ezif/Formula-Student-Dashboard/README.md

# Formula Student Dashboard


Custom dashboard designed for a Formula Student vehicle, built around the Raspberry Pi Compute Module 4/5.

## Overview


Custom CM5 carrier PCB and a complete mechanical enclosure for the vehicle dashboard with an emphasis on weight, reliability, and cost.

### PCB


- Designed the custom Raspberry Pi CM5 carrier PCB from scratch in Altium Designer.
- Integrated USB, Ethernet, and HDMI connectivity.
- Designed power-down circuitry incorporating hold-up capacitors to provide stored energy during power loss.
- Implemented a hardware trigger interface to the microcontroller for power-down event handling.

## Features

- Custom CM5 carrier-board design
- USB, Ethernet, and HDMI interfaces
- Power-loss detection and controlled-shutdown support
- Capacitive energy storage for power-down handling
- Integrated electromechanical packaging

## Tools

- PCB design: Altium Designer
- Mechanical CAD: SolidWorks

## Status

- Deployed and active on Zips Racing ZR26 since May 2026
