ezif/Formula-Student-Dashboard/Gerbers/Revision AB/JLCPCB Dash REV AB BOM.xlsx

Line # | Name | Description | Designator | Quantity | Manufacturer 1 | Manufacturer Part Number 1 | LCSC Part Number | Supplier 1 | Supplier Part Number 1 | Supplier Unit Price 1 | Supplier Subtotal 1
 | 3034TR | Coin Cell Battery Holders COIN CELL RETAINER T APE/REEL 500PC | BT1 | 1 | Keystone | 3034TR | C5213768 | DigiKey | 36-3034CT-ND | 0.47 | 0.47
 | Capacitor 10nF 0603 5% | Capacitor, 0603, 5% | C18 | 1 | KEMET | C0603C103K4REC7867 | C57112
 | Capacitor 6.8pF 0603 5% | Capacitor, 0603, 5% | C28 | 1 | Murata | GCM1885C2A6R8BA16D | C162244 | DigiKey | 490-GCM1885C2A6R8BA16DCT-ND | 0.14 | 0.14
 | Capacitor 4.7nF 0603 10% | Capacitor, 0603, 5% | C29 | 1 | Murata | GCM188R72A472KA37D | C1621 | DigiKey | 490-4930-1-ND | 0.1 | 0.1
 | 293D107X9010D2TE3 | Solid Tantalum Chip Capacitor, 100 uF, +/- 10%, 10 V, -55 to 125 degC, 2917 (7343 Metric), RoHS, Tape and Reel | C38 | 1 | Vishay | 293D107X9010D2TE3 | 293D107X9010D2TE3 | Mouser | 74-293D107X9010D2TE3 | 0.66 | 0.66
 | B160B-13-F | Rectifier Diode, Schottky, 1 Phase, 1 Element, 1A, 60V V(RRM), Silicon | D6 | 1 | Diodes Inc. | B160B-13-F | C80301 | DigiKey | B160B-FDICT-ND | 0.32 | 0.32
 | VS-50WQ10FN-M3 | Rectifier Diode, Schottky, 1 Phase, 1 Element, 5.5A, 100V V(RRM), Silicon, TO-252AA | D7 | 1 | Vishay | VS-50WQ10FN-M3 | C5158795 | DigiKey | VS-50WQ10FN-M3-ND | 0.42 | 0.42
 | LTST-C190KFKT | LED Uni-Color Orange, 75 mW, 30 mA, -35 to 85 degC, 2-Pin SMD, RoHS, Tape and Reel | DS1 | 1 | Lite-On | LTST-C190KFKT | C157740 | DigiKey | 160-1434-1-ND | 0.11 | 0.11
 | LTST-C190GKT | LED Uni-Color Green, 100 mW, 30 mA, -55 to 85 degC, 2-Pin SMD, RoHS, Tape and Reel | DS2 | 1 | Lite-On | LTST-C190GKT | C125093 | DigiKey | 160-LTST-C190GKTDKR-ND | 0.14 | 0.14
 | 1747981-1 | HDMI Receptacle, Pitch 0.5 mm, 19 Position, Height 6.38 mm, RoHS, Tape and Reel | J1 | 1 | TE Connectivity | 1-1747981-1 | C428484 | Mouser | 571-1-1747981-1 | 5.73 | 5.73
 | NRS6028T4R7MMGKV | Inductor Power Shielded Wirewound 4.7uH 20% 100KHz Ferrite 3A 0.0403Ohm DCR 2424 Automotive T/R | L1 | 1 | TAIYO YUDEN | NRS6028T4R7MMGKV | DNP | Mouser | 963-NRS6028T4R7MMGKV | 0.29 | 0.29
 | 503148-2090 | Signal and Industrial Connectors; MOLEX; 503148-2090; Right Angle; JP; 2; Solder | P1 | 1 | Molex | 503148-2090 | DNP | DigiKey | WM9451CT-ND | 3.26 | 3.26
 | AP7343DQ-33W5-7 | Fixed Positive LDO Regulator | PS1 | 1 | Diodes Inc. | AP7343DQ-33W5-7 | C5183854 | DigiKey | AP7343DQ-33W5-7DICT-ND | 0.2 | 0.2
 | CRM2512-FX-1R00ELF | CRCW FIXED RESISTOR 2512 (6432Metric) Chip Resistor ±1% ±100ppm/C 1.1kOhm 1W | R7 | 1 | Bourns | CRM2512-FX-1R00ELF | C11254 | Mouser | 652-CRM2512FX1R00ELF | 0.7 | 0.7
 | Resistor 60k4 0603 1% | Resistor, 0603, 1%, 1/10W | R8 | 1 | Stackpole Electronics | RMCF0603FT60K4 | C23089 | DigiKey | RMCF0603FT60K4CT-ND | 0.1 | 0.1
 | Resistor 23k7 0603 1% | Resistor, 0603, 1%, 1/10W | R11 | 1 | Stackpole Electronics | RMCF0603FT23K7 | C22912 | DigiKey | RMCF0603FT23K7CT-ND | 0.1 | 0.1
 | Resistor 1k21 0603 1% | Resistor, 0603, 1%, 1/10W | R17 | 1 | Stackpole Electronics | RMCF0603FT1K21 | C137779 | DigiKey | RMCF0603FT1K21CT-ND | 0.1 | 0.1
 | Resistor 15k 0603 1% | Resistor, 0603, 1%, 1/10W | R31 | 1 | Stackpole Electronics | RMCF0603FT15K0 | C177330 | DigiKey | RMCF0603FT15K0CT-ND | 0.1 | 0.1
 | PT61020EL | Telecom Transformer 1CT: 1 0.9Ohm Prim. DCR 0.9Ohm Sec. DCR 24 Terminal Gull Wing SMD | T1 | 1 | Bourns | PT61020EL | C840585 | Mouser | 652-PT61020EL | 2.54 | 2.54
 | RT9742SNGV | USWI00154 / RT9742SNGV; Available until stocks are exhausted | U3 | 1 | Richtek | RT9742SNGV | C3235509 | DigiKey | 1028-RT9742SNGVCT-ND | 0.41 | 0.41
 | TPS54560BQDDARQ1 | Switching Regulator, Current-mode, 5A, 2500kHz Switching Freq-Max, PDSO8 | U4 | 1 | Texas Instruments | TPS54560BQDDARQ1 | DNP | DigiKey | 296-45534-1-ND | 6.54 | 6.54
 | AP22653FDZ-7 | USB Power High Side Switch Single 3V to 5.5V 2.1A 6-Pin WDFN-2020 T/R | U8 | 1 | Diodes Inc. | AP22653FDZ-7 | AP22653FDZ-7 | DigiKey | 31-AP22653FDZ-7CT-ND | 0.36 | 0.36
 | CM5108032 | Raspberry Pi Compute Module CM5 | U9 | 1 |  |  | DNP
 | Capacitor 4.7uF 1210 50V | Capacitor 1210 | C20, C21 | 2 | Samsung Electro-Mechanics | CL32B475KBUYNNE | C47783 | DigiKey | 1276-1292-1-ND | 0.36 | 0.72
 | 47uF 1210 16V | Capacitor 1210 | C22, C23 | 2 | Samsung | CL32A476KOJNNNE | C90142
 | Capacitor 1uF 0805 25V | Capacitor, 0805 | C33, C34 | 2 | Samsung Electro-Mechanics | CL21B105KAFNNNE | C28323 | Mouser | 187-CL21B105KAFNNNE | 0.009 | 0.09
 | PESD1CAN-UX | Trans Voltage Suppressor Diode, 150W, 24V V(RWM), Bidirectional, 2 Element, Silicon | D1, D2 | 2 | Nexperia | PESD1CAN-UX | C152727 | DigiKey | 1727-1306-1-ND | 0.5 | 1
 | 502494-0470 | 2.00mm Pitch CLIK-Mate Wire-to-Board PCB Receptacle, Single Row, Right-Angle, 4 Circuits | J2, J3 | 2 | Molex | 502494-0470 | C587929 | Mouser | 538-502494-0470 | 0.62 | 1.24
 | R-78E12-0.5 | Linear Regulator Replacement DC DC Converter 1 Output 5V - - 1A 8V - 28V Input | PS?_CAN Interface1, PS?_CAN Interface2 | 2 |  |  | DNP
 | DMP2045U-7 | DMP2045U Series 20 V 4.3 A P-Channel Enhancement Mode Mosfet - SOT-23-3 | Q1, Q2 | 2 | Diodes Inc. | DMP2045U-7 | C459541 | Mouser | 621-DMP2045U-7 | 0.17 | 0.34
 | Resistor 4k7 0603 1% | Resistor, 0603, 1%, 1/10W | R1, R2 | 2 | Stackpole Electronics | RMCF0603FT4K70 | C23162 | Mouser | 708-RMCF0603FT4K70 | 0.006 | 0.06
 | Resistor 150k 0603 1% | Resistor, 0603, 1%, 1/10W | R13, R16 | 2 | Stackpole Electronics | RMCF0603FT150K | C22807 | DigiKey | RMCF0603FT150KCT-ND | 0.006 | 0.06
 | MCP25625-E/SS | Interface Circuit, PDSO28 | U1, U2 | 2 | Microchip | MCP25625-E/SS | C184944 | Mouser | 579-MCP25625-E/SS | 3.38 | 6.76
 | ECS-160-20-3X-TR | Crystal 16MHz ±30ppm (Tol) ±50ppm (Stability) 20pF FUND 50Ohm 2-Pin HC-49/USX SMD T/R | Y1, Y2 | 2 | ECS International | ECS-160-20-3X-TR | C387623 | DigiKey | XC1776CT-ND | 0.3 | 0.6
 | Capacitor 10F 0805 5% | Capacitor, 0805, 5% | C35, C36, C37 | 3 | Murata | GRM21BC8YA106ME11L | C15850 | DigiKey | 490-10505-1-ND | 0.28 | 0.84
 | TPD4EUSB30DQAR | Quad 0.8-pF, 5.5-V, ±8-kV ESD protection diode with 5-A 8/20-uS surge rating for USB 3.0 10-USON -40 to 85 | D3, D4, D7 | 3 | Texas Instruments | TPD4EUSB30DQAR | C90627 | DigiKey | 296-28063-6-ND | 1.41 | 4.23
 | TS391IYLT | Low power, single voltage comparator, 200µA, 34V, -37, -40 to 125°C, SOT23-5L, Tape and Reel | U5, U6, U7 | 3 | STMicroelectronics | TS391IYLT | C283306 | Mouser | 511-TS391IYLT | 1.3 | 3.9
 | FC0H224ZFTBR24 | Cap Supercap 0.22F 5.5V -20% to 80% (10.5 X 8.5mm) SMD Cylindrical 25 Ohm 70C T/R | C24, C25, C26, C27 | 4 | KEMET | FC0H224ZFTBR24 | DNP | DigiKey | 399-10941-1-ND | 3.29 | 13.16
 | Resistor 75R 0603 1% | Resistor, 0603, | R3, R4, R5, R6, R10, R15 | 6 | Stackpole Electronics | RMCF0603FT75R0 | C4275 | DigiKey | RMCF0603FT75R0CT-ND | 0.007 | 0.07
 | Resistor 787R 0603 1% | Resistor, 0603, 787R | R18, R21, R22, R23, R24, R25, R26 | 7 | Stackpole Electronics | RMCF0603FT787R | C22369675 | DigiKey | RMCF0603FT787RCT-ND | 0.02 | 0.2
 | Capacitor 22nF 0603 5% | Capacitor, 0603, 5% | C4, C5, C9, C10, C13, C14, C15, C16 | 8 | Murata | GCM188R72A223KA37J | C21122 | Mouser | 81-GCM188R72A223KA7J | 0.035 | 0.35
 | Resistor 11k5 0603 1% | Resistor, 0603, 1%, 1/10W | R9, R12, R14, R19, R20, R27, R28, R29, R30 | 9 | Stackpole Electronics | RMCF0603FT11K5 | C177454 | DigiKey | RMCF0603FT11K5CT-ND | 0.006 | 0.06
 | Capacitor 100nF 0603 5% | Capacitor, 0603, 5% | C1, C2, C3, C6, C7, C8, C11, C12, C17, C19, C30, C31, C32 | 13 | KYOCERA AVX | KGM15BR71H104JT | C1591 | Mouser | 581-KGM15BR71H104JT | 0.051 | 0.663
 | 5019 | Interconnection Device | 1, CAP1, CS1, CS2, GD1, GND1, IN+1, INT1, INT2, MISO1, MISO2, MOSI1, MOSI2, PDWN1, PRE1, SCK1, SCK2, SRC1, STBY1, STBY2, VIN1 | 21 | Keystone | 5019 | C238131 | DigiKey | 36-5019CT-ND | 0.186 | 3.91
