ezif/Formula-Student-Dashboard/Gerbers/Revision AA/Working Board Dashboard REVAA.xlsx

Line # | Name | Description | Designator | Quantity | Manufacturer 1 | Manufacturer Part Number 1 | Manufacturer Lifecycle 1 | Supplier 1 | Supplier Part Number 1 | Supplier Unit Price 1 | Supplier Subtotal 1
 | 3034TR | Coin Cell Battery Holders COIN CELL RETAINER T APE/REEL 500PC | BT1 | 1 | Keystone | 3034TR | Volume Production | DigiKey | 36-3034CT-ND | 0.47 | 0.47
 | Capacitor 10nF 0603 5% | Capacitor, 0603, 5% | C18 | 1 | KEMET | C0603C103K4REC7867 | Unknown | Arrow Electronics | C0603C103K4REC7867 | 0.0143 | 57.2
 | Capacitor 10uF 1210 50V | Capacitor 1210 | C28 | 1 | Samsung Electro-Mechanics | CL32A106KBJNNNE | Volume Production | DigiKey | 1276-3363-6-ND | 0.52 | 0.52
 | Capacitor 47uF 1206 20% | 1206 47 uF 6.3 V ±20% Tolerance X7U Multilayer Ceramic Chip Capacitor | C29 | 1 | Murata | GRM31CE70J476ME15L | Volume Production | Future Electronics | 1104123 | 0.355 | 0.355
 | 293D107X9010D2TE3 | Solid Tantalum Chip Capacitor, 100 uF, +/- 10%, 10 V, -55 to 125 degC, 2917 (7343 Metric), RoHS, Tape and Reel | C38 | 1 | Vishay | 293D107X9010D2TE3 | Volume Production | Conrad | 3027093 | 0.62924 | 0.62924
 | B160B-13-F | Rectifier Diode, Schottky, 1 Phase, 1 Element, 1A, 60V V(RRM), Silicon | D5 | 1 | Diodes Inc. | B160B-13-F | Volume Production | Mouser | 621-B160B-F | 0.32 | 0.32
 | LTST-C190KFKT | LED Uni-Color Orange, 75 mW, 30 mA, -35 to 85 degC, 2-Pin SMD, RoHS, Tape and Reel | DS1 | 1 | Lite-On | LTST-C190KFKT | Volume Production | Arrow Electronics | LTST-C190KFKT | 0.009 | 0.009
 | LTST-C190GKT | LED Uni-Color Green, 100 mW, 30 mA, -55 to 85 degC, 2-Pin SMD, RoHS, Tape and Reel | DS2 | 1 | Lite-On | LTST-C190GKT | Not Recommended for New Design | DigiKey | 160-LTST-C190GKTDKR-ND | 0.12 | 0.12
 | 1747981-1 | HDMI Receptacle, Pitch 0.5 mm, 19 Position, Height 6.38 mm, RoHS, Tape and Reel | J1 | 1 | TE Connectivity | 1-1747981-1 | Volume Production | Mouser | 571-1-1747981-1 | 5.23 | 5.23
 | USB-A1HSW6 |  | J2 | 1
 | 9-1462038-9 | Rf Relay, Dpdt, Momentary, 0.028A (Coil), 5Vdc (Coil), 140Mw (Coil), 5A (Contact), 220Vdc | K1 | 1
 | VLS6045EX-6R8M | Inductor Power Shielded Wirewound 6.8uH 20% 100KHz Ferrite 3.6A 0.0468Ohm DCR 2424 T/R | L1 | 1 | TDK | VLS6045EX-6R8M | Volume Production | Mouser | 810-VLS6045EX-6R8M | 0.3 | 0.3
 | 503148-2090 | Signal and Industrial Connectors; MOLEX; 503148-2090; Right Angle; JP; 2; Solder | P1 | 1 | Molex | 503148-2090 | Volume Production | DigiKey | WM9451CT-ND | 3.26 | 3.26
 | AP7343DQ-33W5-7 | Fixed Positive LDO Regulator | PS1 | 1 | Diodes Inc. | AP7343DQ-33W5-7 | Volume Production | DigiKey | AP7343DQ-33W5-7DICT-ND | 0.2 | 0.2
 | RES_2512_33 | RES SMD 33 OHM 1% 2512 | R14 | 1
 | 5033981892 | Micro SD Card Connector, Pitch 1.1 mm, 8 Position, Height 1.4 mm, -25 to 85 degC, RoHS, Tape and Reel | SKT1 | 1 | Molex | 503398-1892 | Volume Production | Conrad | 2449113 | 1.57 | 1.57
 | PT61020EL | Telecom Transformer 1CT: 1 0.9Ohm Prim. DCR 0.9Ohm Sec. DCR 24 Terminal Gull Wing SMD | T1 | 1 | Bourns | PT61020EL | Volume Production | DigiKey | PT61020ELCT-ND | 2.54 | 2.54
 | RT9742SNGV | USWI00154 / RT9742SNGV; Available until stocks are exhausted | U3 | 1 | Richtek | RT9742SNGV | Volume Production | DigiKey | 1028-RT9742SNGVCT-ND | 0.41 | 0.41
 | LMR51430XDDCR | SIMPLE SWITCHER® 4.5-V to 36-V, 3-A synchronous buck converter with 40-µA IQ 6-SOT-23-THIN -40 to 150 | U4 | 1 | Texas Instruments | LMR51430XDDCR | Volume Production | DigiKey | 296-LMR51430XDDCRDKR-ND | 1.58 | 1.58
 | LM393DR2G | LM Series 36 V 250 nA Surface Mount Low Offset Voltage Dual Comparator - SOIC-8 | U5 | 1 | onsemi | LM393DR2G | Volume Production | Conrad | 3028167 | 0.15148 | 0.15148
 | RT9742GGJ5 | 2.7V~6V 70mΩ 1A TSOT-23-5 Power Distribution Switches ROHS | U6 | 1 | Richtek | RT9742GGJ5 | Volume Production | DigiKey | 1028-1436-1-ND | 0.58 | 0.58
 | AP22653W6-7 | USB Power High Side Switch Single 3V to 5.5V 2.1A 6-Pin SOT-26 T/R | U7 | 1 | Diodes Inc. | AP22653W6-7 | Volume Production | Newark | AP22653W6-7 | 0.36 | 1.8
 | CM5108032 | Raspberry Pi Compute Module CM5 | U8 | 1
 | Capacitor 1uF 0805 25V | Capacitor, 0805 | C31, C32 | 2 | Samsung Electro-Mechanics | CL21B105KAFNNNE | Volume Production | DigiKey | 1276-1066-1-ND | 0.009 | 0.09
 | PESD1CAN-UX | Trans Voltage Suppressor Diode, 150W, 24V V(RWM), Bidirectional, 2 Element, Silicon | D1, D2 | 2 | Nexperia | PESD1CAN-UX | Volume Production
 | TPD4EUSB30DQAR | Quad 0.8-pF, 5.5-V, ±8-kV ESD protection diode with 5-A 8/20-uS surge rating for USB 3.0 10-USON -40 to 85 | D3, D4 | 2 | Texas Instruments | TPD4EUSB30DQAR | Volume Production | DigiKey | 296-28063-1-ND | 1.25 | 2.5
 | 502494-0470 | 2.00mm Pitch CLIK-Mate Wire-to-Board PCB Receptacle, Single Row, Right-Angle, 4 Circuits | J3, J4 | 2 | Molex | 502494-0470 | Volume Production | Arrow Electronics | 5024940470 | 0.194 | 0.388
 | DMP2045U-7 | DMP2045U Series 20 V 4.3 A P-Channel Enhancement Mode Mosfet - SOT-23-3 | Q1, Q2 | 2 | Diodes Inc. | DMP2045U-7 | Volume Production | RS (Formerly Allied Electronics) | 73928969 | 0.054 | 0.108
 | Resistor 4k7 0603 1% | Resistor, 0603, 1%, 1/10W | R1, R2 | 2 | Stackpole Electronics | RMCF0603FT4K70 | Volume Production | Mouser | 708-RMCF0603FT4K70 | 0.01 | 0.1
 | Resistor 604k 0603 1% | Resistor, 1%, 0603 | R12, R20 | 2 | Stackpole Electronics | RMCF0603FT604K | Volume Production | Mouser | 708-RMCF0603FT604K | 0.007 | 0.07
 | MCP25625-E/SS | Interface Circuit, PDSO28 | U1, U2 | 2 | Microchip | MCP25625-E/SS | Volume Production | Arrow Electronics | MCP25625-E/SS | 1.21 | 2.41
 | ECS-160-20-3X-TR | Crystal 16MHz ±30ppm (Tol) ±50ppm (Stability) 20pF FUND 50Ohm 2-Pin HC-49/USX SMD T/R | Y1, Y2 | 2 | ECS International | ECS-160-20-3X-TR | Volume Production | DigiKey | XC1776CT-ND | 0.3 | 0.6
 | Resistor 15k 0603 1% | Resistor, 0603, 1%, 1/10W | R8, R18, R22 | 3 | Stackpole Electronics | RMCF0603FT15K0 | Volume Production | Mouser | 708-RMCF0603FT15K0 | 0.007 | 0.07
 | Capacitor 47pF +/- 5% 0603 C0G | Capacitor, 0603, 5% | C4, C5, C9, C10 | 4 | TDK | C1608C0G1H470J080AA | Volume Production | Newark | C1608C0G1H470J080AA | 0.007 | 0.028
 | Capacitor 22nF 0603 5% | Capacitor, 0603, 5% | C13, C14, C15, C16 | 4 | Murata | GCM188R72A223KA37J | Volume Production | Mouser | 81-GCM188R72A223KA7J | 0.032 | 0.32
 | Capacitor 10F 0805 5% | Capacitor, 0805, 5% | C34, C35, C36, C37 | 4 | Murata | GRM21BC8YA106ME11L | Volume Production | DigiKey | 490-10505-1-ND | 0.28 | 1.12
 | Resistor 75R 0603 1% | Resistor, 0603, | R3, R4, R5, R6, R9, R15 | 6 | Stackpole Electronics | RMCF0603FT75R0 | Volume Production | Mouser | 708-RMCF0603FT75R0 | 0.01 | 0.1
 | FC0H224ZFTBR24 | Cap Supercap 0.22F 5.5V -20% to 80% (10.5 X 8.5mm) SMD Cylindrical 25 Ohm 70C T/R | C20, C21, C22, C23, C24, C25, C26, C27 | 8 | KEMET | FC0H224ZFTBR24 | Volume Production | Mouser | 80-FC0H224ZFTBR24 | 2.13 | 21.3
 | Resistor 100k 0603 1% | Resistor, 0603, 1%, 1/10W | R7, R10, R11, R13, R17, R19, R21 | 8 | Stackpole Electronics | RMCF0603FT100K | Volume Production | Mouser | 708-RMCF0603FT100K | 0.007 | 0.07
 | Capacitor 100nF 0603 5% | Capacitor, 0603, 5% | C1, C2, C3, C6, C7, C8, C11, C12, C17, C19, C23 | 11 | KYOCERA AVX | KGM15BR71H104JT | Volume Production | Mouser | 581-KGM15BR71H104JT | 0.051 | 0.561
