ezif/Formula-Student-Dashboard/Gerbers/Revision AC/Zips Racing Dashboard Revision AC JLC.xlsx

LCSC Part Number | Name | Description | Designator | Quantity | Manufacturer 1 | Manufacturer Part Number 1 | Manufacturer Lifecycle 1 | Supplier 1 | Supplier Part Number 1 | Supplier Unit Price 1 | Supplier Subtotal 1
C428484 | 1747981-1 | HDMI Receptacle, Pitch 0.5 mm, 19 Position, Height 6.38 mm, RoHS, Tape and Reel | J1 | 1 | TE Connectivity | 1-1747981-1 | Volume Production | Mouser | 571-1-1747981-1 | 6.01 | 6.01
C840585 | PT61020EL | Telecom Transformer 1CT: 1 0.9Ohm Prim. DCR 0.9Ohm Sec. DCR 24 Terminal Gull Wing SMD | T1 | 1 | Bourns | PT61020EL | Volume Production | Mouser | 652-PT61020EL | 2.54 | 2.54
TPS54560BQDDARQ1 | TPS54560BQDDARQ1 | Switching Regulator, Current-mode, 5A, 2500kHz Switching Freq-Max, PDSO8 | U4 | 1 | Texas Instruments | TPS54560BQDDARQ1 | Volume Production | DigiKey | 296-45534-1-ND | 6.54 | 6.54
TS391IYLT | TS391IYLT | Low power, single voltage comparator, 200µA, 34V, -37, -40 to 125°C, SOT23-5L, Tape and Reel | U5 | 1 | STMicroelectronics | TS391IYLT | Volume Production | Mouser | 511-TS391IYLT | 1.18 | 1.18
C3001604 | AP22653FDZ-7 | USB Power High Side Switch Single 3V to 5.5V 2.1A 6-Pin WDFN-2020 T/R | U9 | 1 | Diodes Inc. | AP22653FDZ-7 | Volume Production | DigiKey | 31-AP22653FDZ-7CT-ND | 0.36 | 0.36
C597931 | DF40C-100DS-0.4V(51) | Conn Stacking Receptacle 100 POS 1.5mm Stack Height 0.4mm Solder ST SMD Emboss T/R | J3, J4 | 2 | HIROSE ELECTRIC | DF40C-100DS-0.4V(51) | Volume Production | Mouser | 798-DF40C100DS0.4V51 | 1.76 | 3.52
C90627 | TPD4EUSB30DQAR | Quad 0.8-pF, 5.5-V, ±8-kV ESD protection diode with 5-A 8/20-uS surge rating for USB 3.0 10-USON -40 to 85 | D3, D4, D5 | 3 | Texas Instruments | TPD4EUSB30DQAR | Volume Production | Bison Technologies | TPD4EUSB30DQAR-62989 | 0.23 | 23
C90142 | 47uF 1210 16V | Capacitor 1210 | C26, C27, C35, C36 | 4 | Samsung | CL32A476KOJNNNE | Unknown
C283306 | Resistor 75R 0603 1% | Resistor, 0603, | R3, R4, R5, R6 | 4 | Stackpole Electronics | RMCF0603FT75R0 | Volume Production | DigiKey | RMCF0603FT75R0CT-ND | 0.007 | 0.07
C177644 | Resistor 10k 0603 1% | Resistor, 0603, 10k | R8, R9, R10, R11 | 4 | Stackpole Electronics | RMCF0603FT10K0 | Volume Production | DigiKey | RMCF0603FT10K0CT-ND | 0.006 | 0.06
C283306 | EEE-FK1V751SQ | Panasonic EEEFK1V751SQ - Aluminum Electrolytic Capacitors (Surface Mount Type) | C28, C29, C30, C31, C39 | 5 | Panasonic | EEE-FK1V751SQ | Volume Production | Mouser | 667-EEE-FK1V751SQ | 1.8 | 9
C177454 | Resistor 11k5 0603 1% | Resistor, 0603, 1%, 1/10W | R17, R24, R25, R32, R33 | 5 | Stackpole Electronics | RMCF0603FT11K5 | Volume Production | DigiKey | RMCF0603FT11K5CT-ND | 0.006 | 0.06
C24452 | Capacitor 100nF 0603 5% | Capacitor, 0603, 5% | C1, C2, C3, C6, C7, C8, C11, C12, C17, C19, C34 | 11 | KYOCERA AVX | KGM15BR71H104JT | Volume Production | Mouser | 581-KGM15BR71H104JT | 0.051 | 0.561
