ezif/Formula-Student-Dashboard/Gerbers/Revision AC/Zips Racing Dashboard Revision AC.xlsx

Line # | Name | Description | Designator | Quantity | Manufacturer 1 | Manufacturer Part Number 1 | Manufacturer Lifecycle 1 | Supplier 1 | Supplier Part Number 1 | Supplier Unit Price 1 | Supplier Subtotal 1
 | Capacitor 10nF 0603 5% | Capacitor, 0603, 5% | C18 | 1 | KEMET | C0603C103K4REC7867 | Unknown
 | 293D107X9010D2TE3 | Solid Tantalum Chip Capacitor, 100 uF, +/- 10%, 10 V, -55 to 125 degC, 2917 (7343 Metric), RoHS, Tape and Reel | C23 | 1 | Vishay | 293D107X9010D2TE3 | Volume Production | Mouser | 74-293D107X9010D2TE3 | 0.6 | 0.6
 | Capacitor 6.8pF 0603 5% | Capacitor, 0603, 5% | C32 | 1 | Murata | GCM1885C2A6R8BA16D | Volume Production | Mouser | 81-GCM1885C2A6R8BA6D | 0.14 | 0.14
 | Capacitor 4.7nF 0603 10% | Capacitor, 0603, 5% | C33 | 1 | Murata | GCM188R72A472KA37D | Not Recommended for New Design | DigiKey | 490-4930-1-ND | 0.1 | 0.1
 | VS-50WQ10FN-M3 | Rectifier Diode, Schottky, 1 Phase, 1 Element, 5.5A, 100V V(RRM), Silicon, TO-252AA | D7 | 1 | Vishay | VS-50WQ10FN-M3 | Volume Production | Mouser | 78-VS-50WQ10FN-M3 | 0.31 | 0.31
 | LTST-C190KFKT | LED Uni-Color Orange, 75 mW, 30 mA, -35 to 85 degC, 2-Pin SMD, RoHS, Tape and Reel | DS1 | 1 | Lite-On | LTST-C190KFKT | Volume Production | DigiKey | 160-1434-1-ND | 0.11 | 0.11
 | CM5-ICON | Raspberry Pi Compute Module CM5 | ICON1 | 1
 | 1747981-1 | HDMI Receptacle, Pitch 0.5 mm, 19 Position, Height 6.38 mm, RoHS, Tape and Reel | J1 | 1 | TE Connectivity | 1-1747981-1 | Volume Production | Mouser | 571-1-1747981-1 | 6.01 | 6.01
 | NRS6028T4R7MMGKV | Inductor Power Shielded Wirewound 4.7uH 20% 100KHz Ferrite 3A 0.0403Ohm DCR 2424 Automotive T/R | L1 | 1 | TAIYO YUDEN | NRS6028T4R7MMGKV | Volume Production | DigiKey | 587-3639-1-ND | 0.29 | 0.29
 | 503148-2090 | Signal and Industrial Connectors; MOLEX; 503148-2090; Right Angle; JP; 2; Solder | P1 | 1 | Molex | 503148-2090 | Volume Production | DigiKey | WM9451CT-ND | 3.26 | 3.26
 | AP7343DQ-33W5-7 | Fixed Positive LDO Regulator | PS1 | 1 | Diodes Inc. | AP7343DQ-33W5-7 | Volume Production | DigiKey | AP7343DQ-33W5-7DICT-ND | 0.2 | 0.2
 | R-78E5.0-1.0 | Linear Regulator Replacement DC DC Converter 1 Output 5V - - 1A 8V - 28V Input | PS2 | 1 | Recom Power | R-78E5.0-1.0 | Volume Production | DigiKey | 945-2201-ND | 3.97 | 3.97
 | Resistor 15k 0603 1% | Resistor, 0603, 1%, 1/10W | R7 | 1 | Stackpole Electronics | RMCF0603FT15K0 | Volume Production | DigiKey | RMCF0603FT15K0CT-ND | 0.1 | 0.1
 | CRM2512-JW-220ELF | Res Thick Film 2512 22 Ohm 5% 2W ±200ppm/C Pad SMD T/R | R12 | 1 | Bourns | CRM2512-JW-220ELF | Volume Production | Mouser | 652-CRM2512-JW220ELF | 0.44 | 0.44
 | Resistor 60k4 0603 1% | Resistor, 0603, 1%, 1/10W | R13 | 1 | Stackpole Electronics | RMCF0603FT60K4 | Volume Production | DigiKey | RMCF0603FT60K4CT-ND | 0.1 | 0.1
 | Resistor 23k7 0603 1% | Resistor, 0603, 1%, 1/10W | R16 | 1 | Stackpole Electronics | RMCF0603FT23K7 | Volume Production | DigiKey | RMCF0603FT23K7CT-ND | 0.1 | 0.1
 | PT61020EL | Telecom Transformer 1CT: 1 0.9Ohm Prim. DCR 0.9Ohm Sec. DCR 24 Terminal Gull Wing SMD | T1 | 1 | Bourns | PT61020EL | Volume Production | Mouser | 652-PT61020EL | 2.54 | 2.54
 | RT9742SNGV | USWI00154 / RT9742SNGV; Available until stocks are exhausted | U3 | 1 | Richtek | RT9742SNGV | Volume Production | DigiKey | 1028-RT9742SNGVCT-ND | 0.41 | 0.41
 | TPS54560BQDDARQ1 | Switching Regulator, Current-mode, 5A, 2500kHz Switching Freq-Max, PDSO8 | U4 | 1 | Texas Instruments | TPS54560BQDDARQ1 | Volume Production | DigiKey | 296-45534-1-ND | 6.54 | 6.54
 | TS391IYLT | Low power, single voltage comparator, 200µA, 34V, -37, -40 to 125°C, SOT23-5L, Tape and Reel | U5 | 1 | STMicroelectronics | TS391IYLT | Volume Production | Mouser | 511-TS391IYLT | 1.18 | 1.18
 | AP22653FDZ-7 | USB Power High Side Switch Single 3V to 5.5V 2.1A 6-Pin WDFN-2020 T/R | U9 | 1 | Diodes Inc. | AP22653FDZ-7 | Volume Production | DigiKey | 31-AP22653FDZ-7CT-ND | 0.36 | 0.36
 | Capacitor 4.7uF 1210 50V | Capacitor 1210 | C24, C25 | 2 | Samsung Electro-Mechanics | CL32B475KBUYNNE | Volume Production | Mouser | 187-CL32B475KBUYNNE | 0.37 | 0.74
 | Capacitor 1uF 0805 25V | Capacitor, 0805 | C37, C38 | 2 | Samsung Electro-Mechanics | CL21B105KAFNNNE | Volume Production | Mouser | 187-CL21B105KAFNNNE | 0.1 | 0.2
 | Capacitor 10uF 1210 50V | Capacitor 1210 | C40, C41 | 2 | Samsung Electro-Mechanics | CL32A106KBJNNNE | Volume Production | DigiKey | 1276-3363-1-ND | 0.56 | 1.12
 | PESD1CAN-UX | Trans Voltage Suppressor Diode, 150W, 24V V(RWM), Bidirectional, 2 Element, Silicon | D1, D2 | 2 | Nexperia | PESD1CAN-UX | Volume Production | DigiKey | 1727-1306-6-ND | 0.5 | 1
 | RB161MM-20TR | RB161MM Series 25 V 1 A Surface Mount Schottky Barrier Diode - SOD-123FL | D6, D8 | 2 | ROHM | RB161MM-20TR | Volume Production | Mouser | 755-RB161MM-20TR | 0.48 | 0.96
 | LTST-C190GKT | LED Uni-Color Green, 100 mW, 30 mA, -55 to 85 degC, 2-Pin SMD, RoHS, Tape and Reel | DS2, DS3 | 2 | Lite-On | LTST-C190GKT | Not Recommended for New Design | DigiKey | 160-LTST-C190GKTCT-ND | 0.14 | 0.28
 | 502494-0470 | 2.00mm Pitch CLIK-Mate Wire-to-Board PCB Receptacle, Single Row, Right-Angle, 4 Circuits | J2, J?2 | 2 | Molex | 502494-0470 | Volume Production | Mouser | 538-502494-0470 | 0.62 | 1.24
 | DF40C-100DS-0.4V(51) | Conn Stacking Receptacle 100 POS 1.5mm Stack Height 0.4mm Solder ST SMD Emboss T/R | J3, J4 | 2 | HIROSE ELECTRIC | DF40C-100DS-0.4V(51) | Volume Production | Mouser | 798-DF40C100DS0.4V51 | 1.76 | 3.52
 | Resistor 150k 0603 1% | Resistor, 0603, 1%, 1/10W | R18, R21 | 2 | Stackpole Electronics | RMCF0603FT150K | Volume Production | DigiKey | RMCF0603FT150KCT-ND | 0.006 | 0.06
 | Resistor 787R 0603 1% | Resistor, 0603, 787R | R27, R29 | 2 | Stackpole Electronics | RMCF0603FT787R | Volume Production | DigiKey | RMCF0603FT787RCT-ND | 0.1 | 0.2
 | MCP25625-E/SS | Interface Circuit, PDSO28 | U1, U2 | 2 | Microchip | MCP25625-E/SS | Volume Production | Mouser | 579-MCP25625-E/SS | 3.38 | 6.76
 | ECS-160-20-3X-TR | Crystal 16MHz ±30ppm (Tol) ±50ppm (Stability) 20pF FUND 50Ohm 2-Pin HC-49/USX SMD T/R | Y1, Y2 | 2 | ECS International | ECS-160-20-3X-TR | Volume Production | DigiKey | XC1776CT-ND | 0.3 | 0.6
 | Capacitor 10F 0805 5% | Capacitor, 0805, 5% | C20, C21, C22 | 3 | Murata | GRM21BC8YA106ME11L | Volume Production | DigiKey | 490-10505-1-ND | 0.29 | 0.87
 | TPD4EUSB30DQAR | Quad 0.8-pF, 5.5-V, ±8-kV ESD protection diode with 5-A 8/20-uS surge rating for USB 3.0 10-USON -40 to 85 | D3, D4, D5 | 3 | Texas Instruments | TPD4EUSB30DQAR | Volume Production | Bison Technologies | TPD4EUSB30DQAR-62989 | 0.23 | 23
 | Resistor 4k7 0603 1% | Resistor, 0603, 1%, 1/10W | R1, R2, R36 | 3 | Stackpole Electronics | RMCF0603FT4K70 | Volume Production | DigiKey | RMCF0603FT4K70CT-ND | 0.006 | 0.06
 | Capacitor 15pF 0603 1% | Capacitor, 0603, 5% | C4, C5, C9, C10 | 4 | Walsin Technologies | 0603N150F500CT | Volume Production | Mouser | 791-0603N150F500CT | 0.029 | 0.29
 | Capacitor 22nF 0603 5% | Capacitor, 0603, 5% | C13, C14, C15, C16 | 4 | Murata | GCM188R72A223KA37J | Volume Production | Mouser | 81-GCM188R72A223KA7J | 0.03 | 0.3
 | 47uF 1210 16V | Capacitor 1210 | C26, C27, C35, C36 | 4 | Samsung | CL32A476KOJNNNE | Unknown
 | Resistor 75R 0603 1% | Resistor, 0603, | R3, R4, R5, R6 | 4 | Stackpole Electronics | RMCF0603FT75R0 | Volume Production | DigiKey | RMCF0603FT75R0CT-ND | 0.007 | 0.07
 | Resistor 10k 0603 1% | Resistor, 0603, 10k | R8, R9, R10, R11 | 4 | Stackpole Electronics | RMCF0603FT10K0 | Volume Production | DigiKey | RMCF0603FT10K0CT-ND | 0.006 | 0.06
 | EEE-FK1V751SQ | Panasonic EEEFK1V751SQ - Aluminum Electrolytic Capacitors (Surface Mount Type) | C28, C29, C30, C31, C39 | 5 | Panasonic | EEE-FK1V751SQ | Volume Production | Mouser | 667-EEE-FK1V751SQ | 1.8 | 9
 | Resistor 11k5 0603 1% | Resistor, 0603, 1%, 1/10W | R17, R24, R25, R32, R33 | 5 | Stackpole Electronics | RMCF0603FT11K5 | Volume Production | DigiKey | RMCF0603FT11K5CT-ND | 0.006 | 0.06
 | Capacitor 100nF 0603 5% | Capacitor, 0603, 5% | C1, C2, C3, C6, C7, C8, C11, C12, C17, C19, C34 | 11 | KYOCERA AVX | KGM15BR71H104JT | Volume Production | Mouser | 581-KGM15BR71H104JT | 0.051 | 0.561
 | 5019 | Interconnection Device | +1, CCS1, CCS2, GND1, IN-1, IN+1, INT1, INT2, MISO1, MISO2, MOSI1, MOSI2, PDWN1, SCK1, SCK2, STBY1, STBY2, VCAP1, VIN1 | 19 | Keystone | 5019 | Volume Production | DigiKey | 36-5019DKR-ND | 0.186 | 3.53
