ezif/Formula-Student-Dashboard/Zips Racing Dashboard Revision AC.pdf

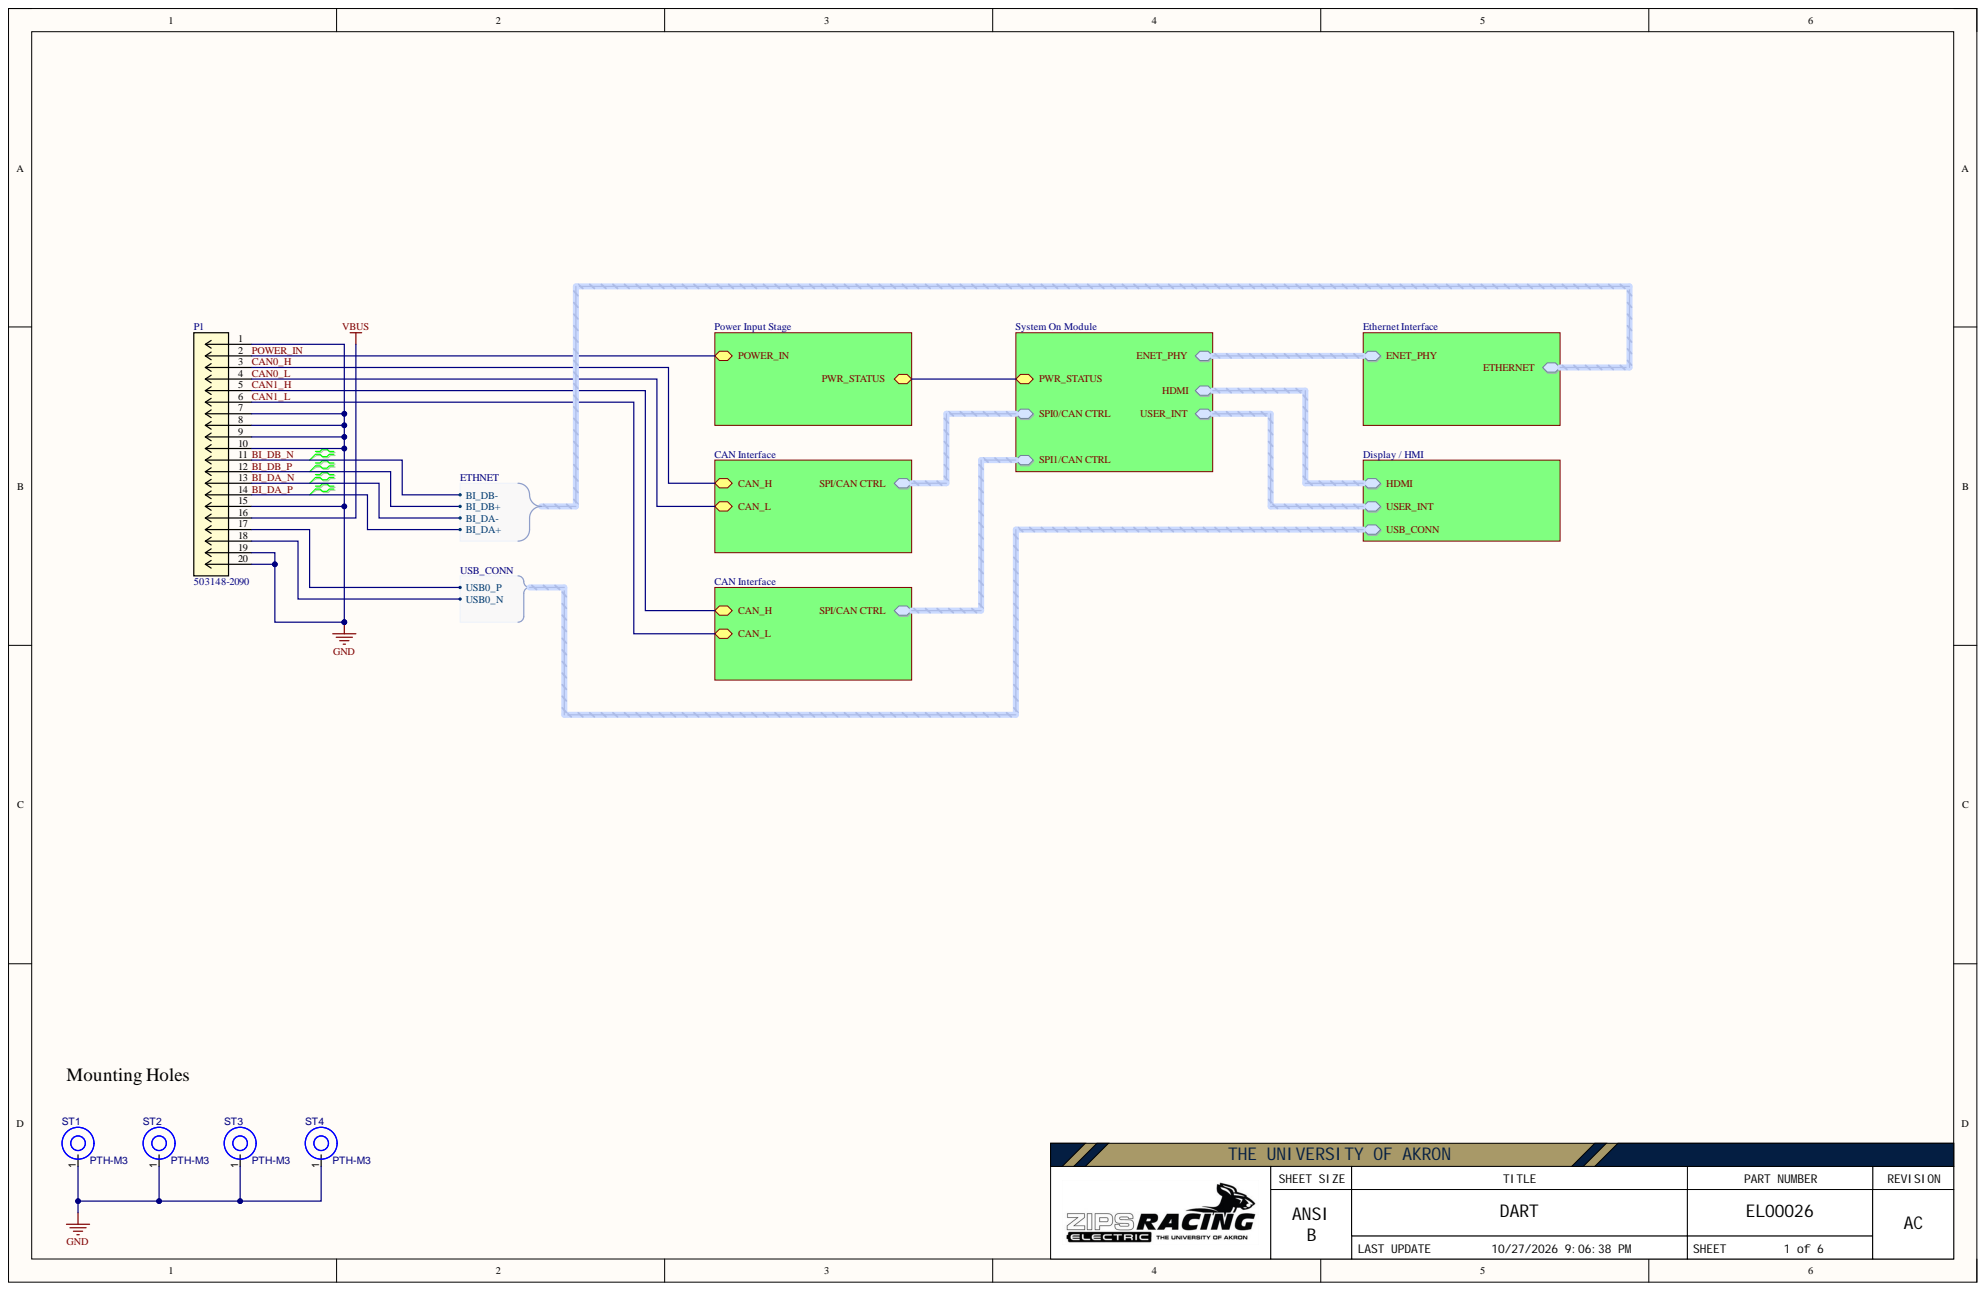
[picture p1: page 1]

THE UNIVERSITY OF AKRON

SHEET SIZE | TITLE | PART NUMBER | REVISION
ANSI B | DART | EL00026 | AC

LAST UPDATE 10/27/2026 9:06:38 PM | SHEET 1 of 6

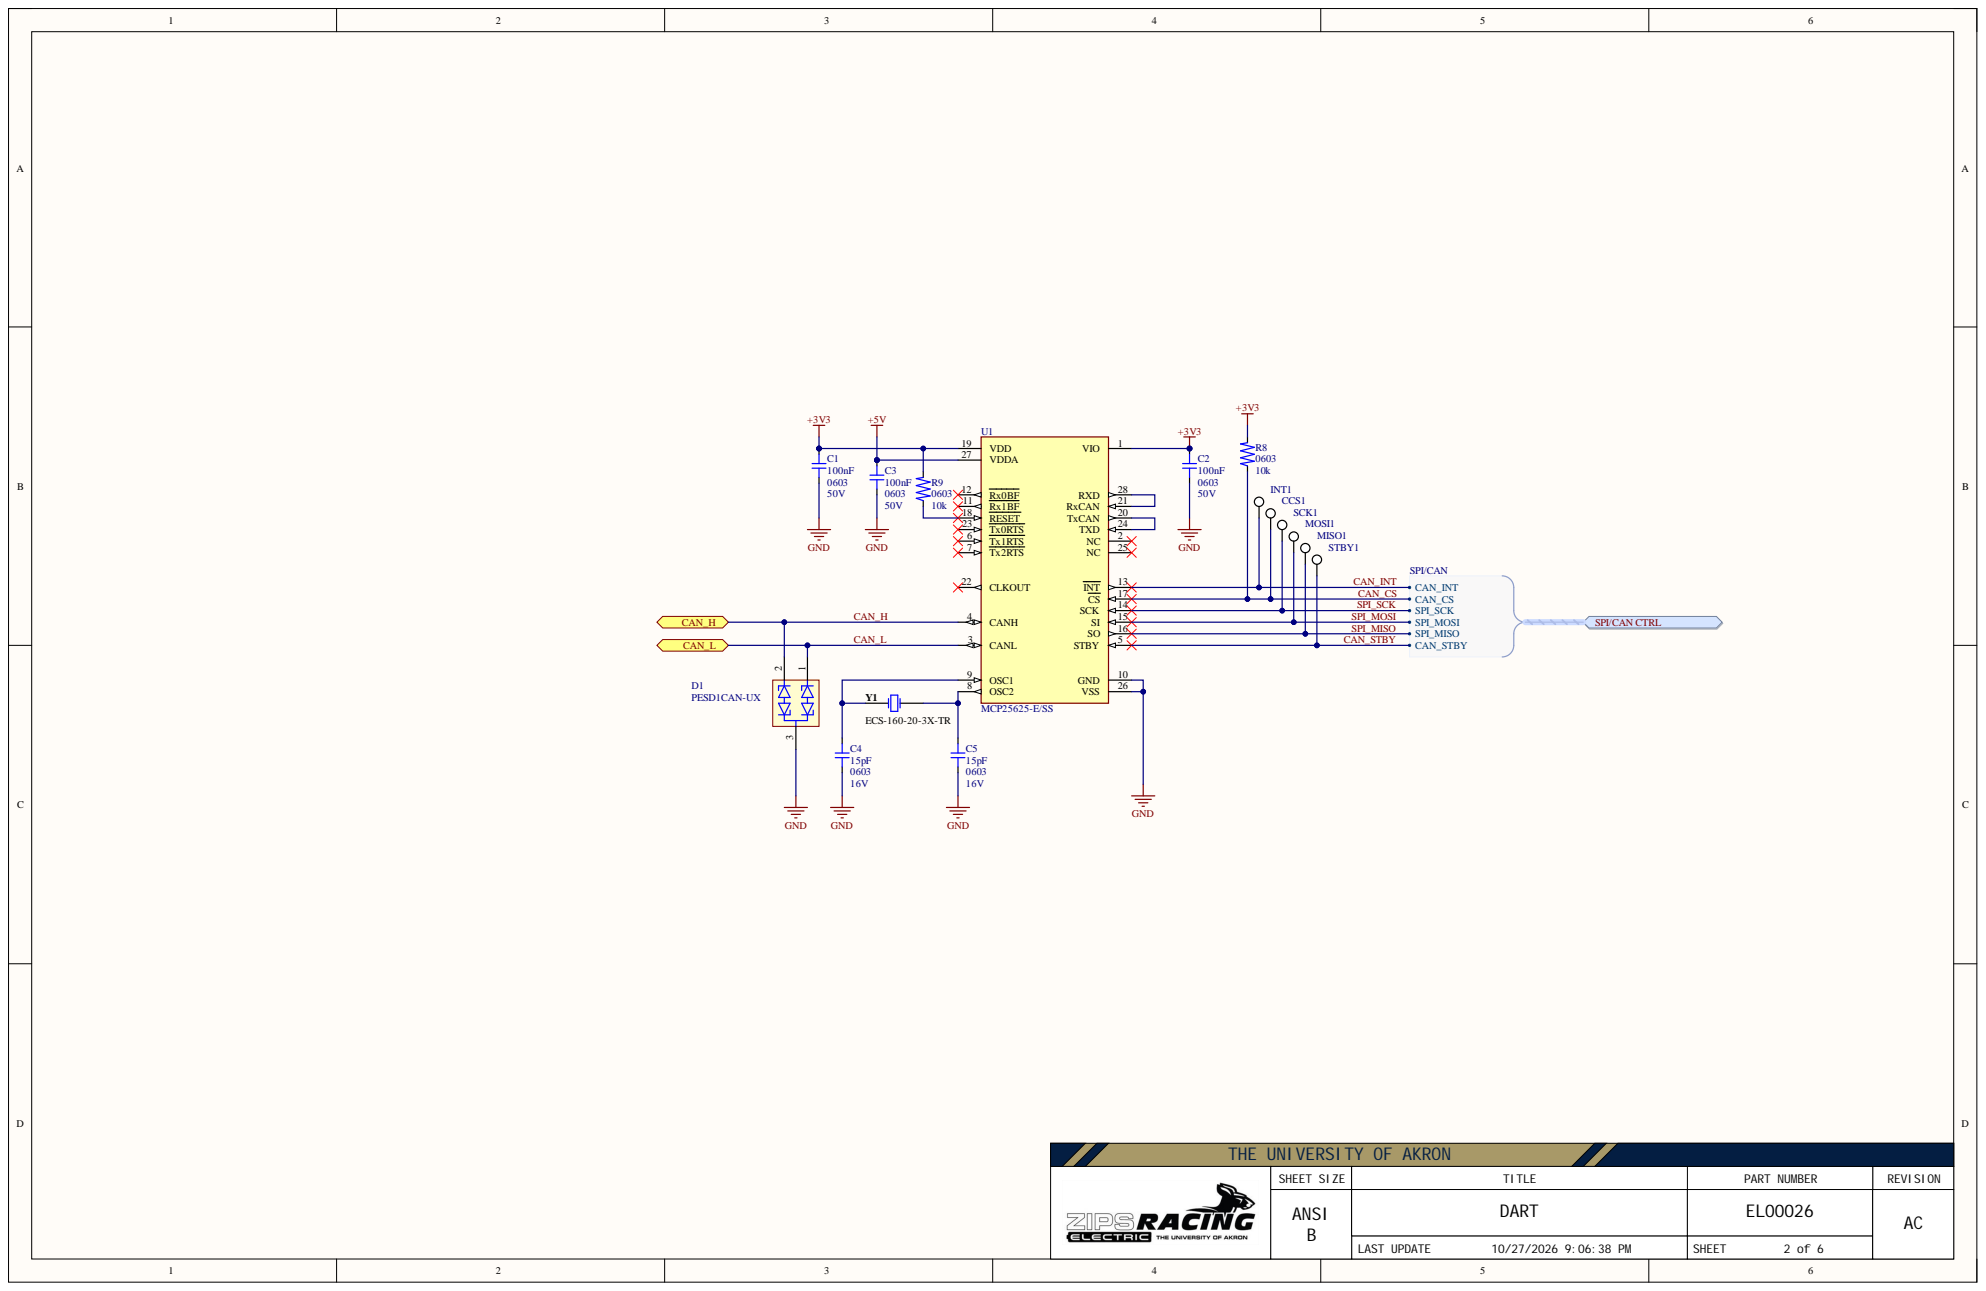
[picture p2: page 2]

THE UNIVERSITY OF AKRON

SHEET SIZE | TITLE | PART NUMBER | REVISION
ANSI B | DART | EL00026 | AC

LAST UPDATE 10/27/2026 9:06:38 PM | SHEET 2 of 6

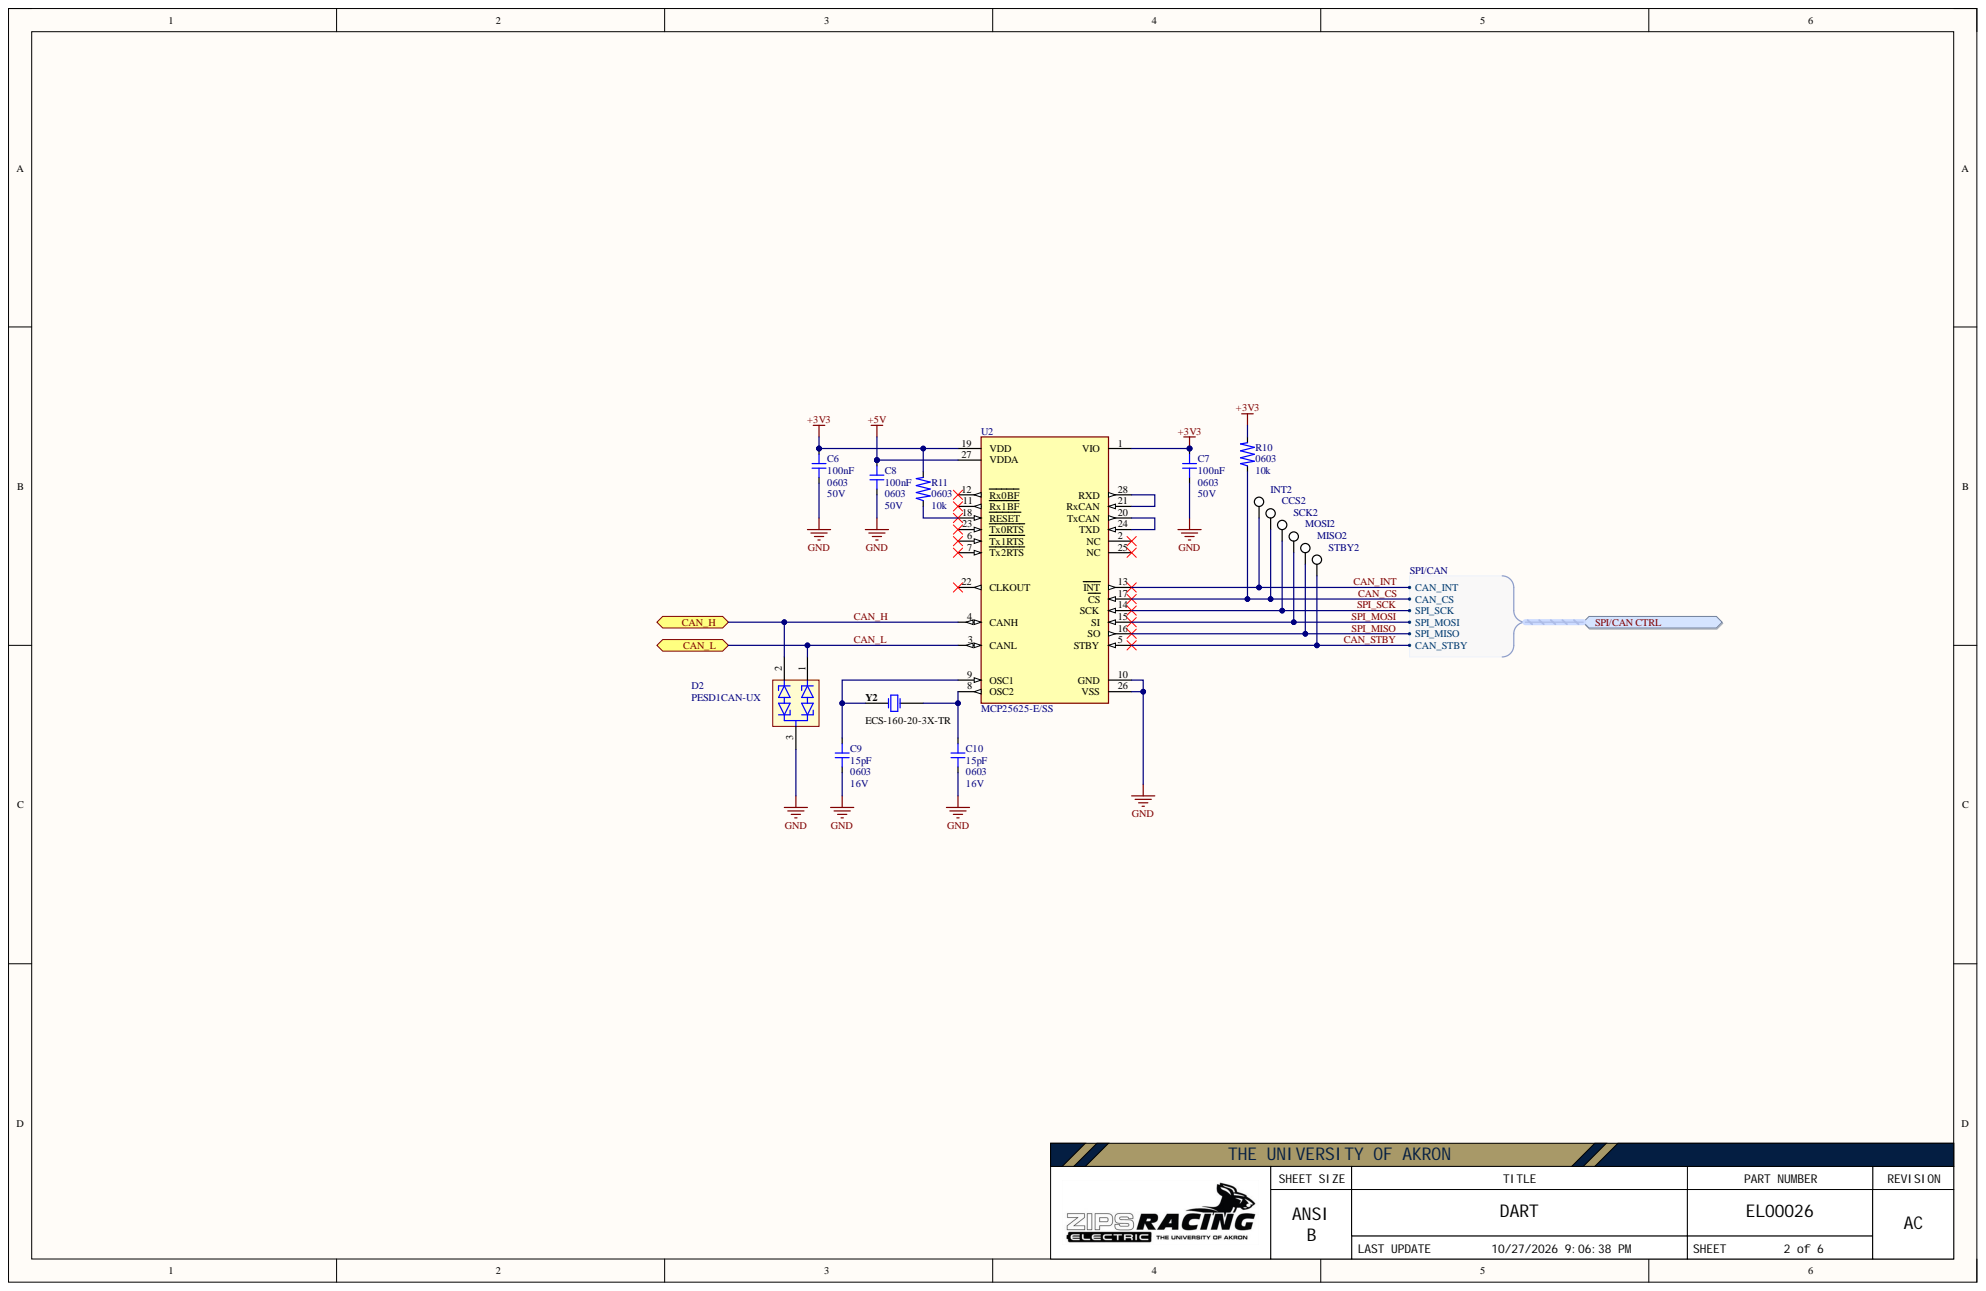
[picture p3: page 3]

THE UNIVERSITY OF AKRON

SHEET SIZE | TITLE | PART NUMBER | REVISION
ANSI B | DART | EL00026 | AC

LAST UPDATE 10/27/2026 9:06:38 PM | SHEET 2 of 6

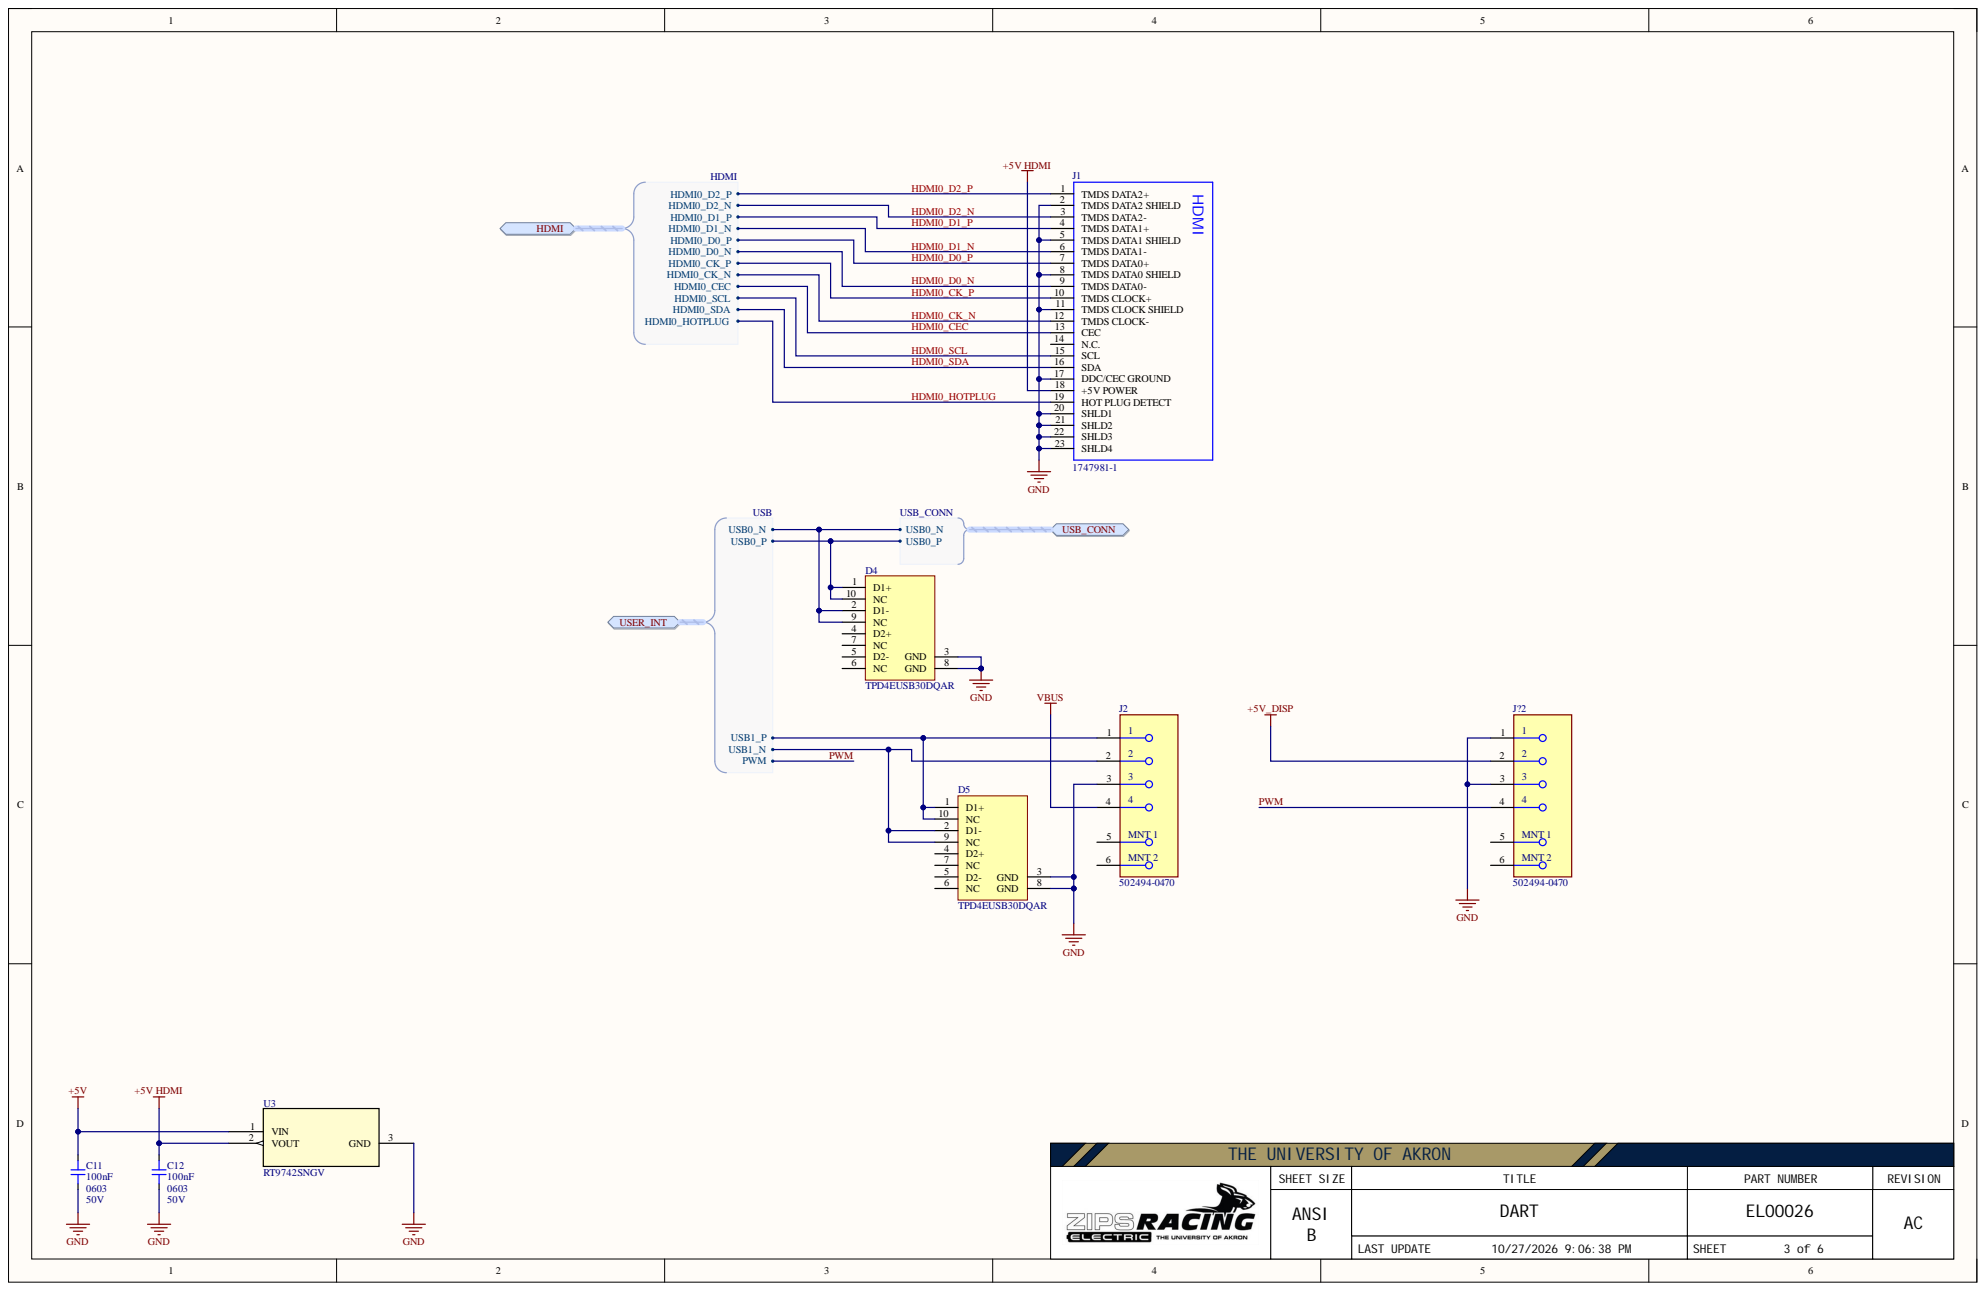
[picture p4: page 4]

TMDS DATA2 SHIELD 2

HDMI0_D2_N | | TMDS DATA2- 3
HDMI0_D1_P | | TMDS DATA1+ 4

HDMI0_D1_N | TMDS DATA1- 6
HDMI0_D0_P | TMDS DATA0+ 7

TMDS DATA1 SHIELD 5

TMDS DATA0 SHIELD 8

HDMI0_D0_N | TMDS DATA0- 9
HDMI0_CK_P | TMDS CLOCK+ 10

TMDS CLOCK SHIELD 11

HDMI0_CK_N | TMDS CLOCK- 12
HDMI0_CEC | CEC 13
HDMI0_SCL | N.C. 14

HDMI0_SDA | SDA 16
HDMI0_HOTPLUG | DDC/CEC GROUND 17

THE UNIVERSITY OF AKRON

SHEET SIZE | TITLE | PART NUMBER | REVISION
ANSI B | DART | EL00026 | AC

LAST UPDATE 10/27/2026 9:06:38 PM | SHEET 3 of 6

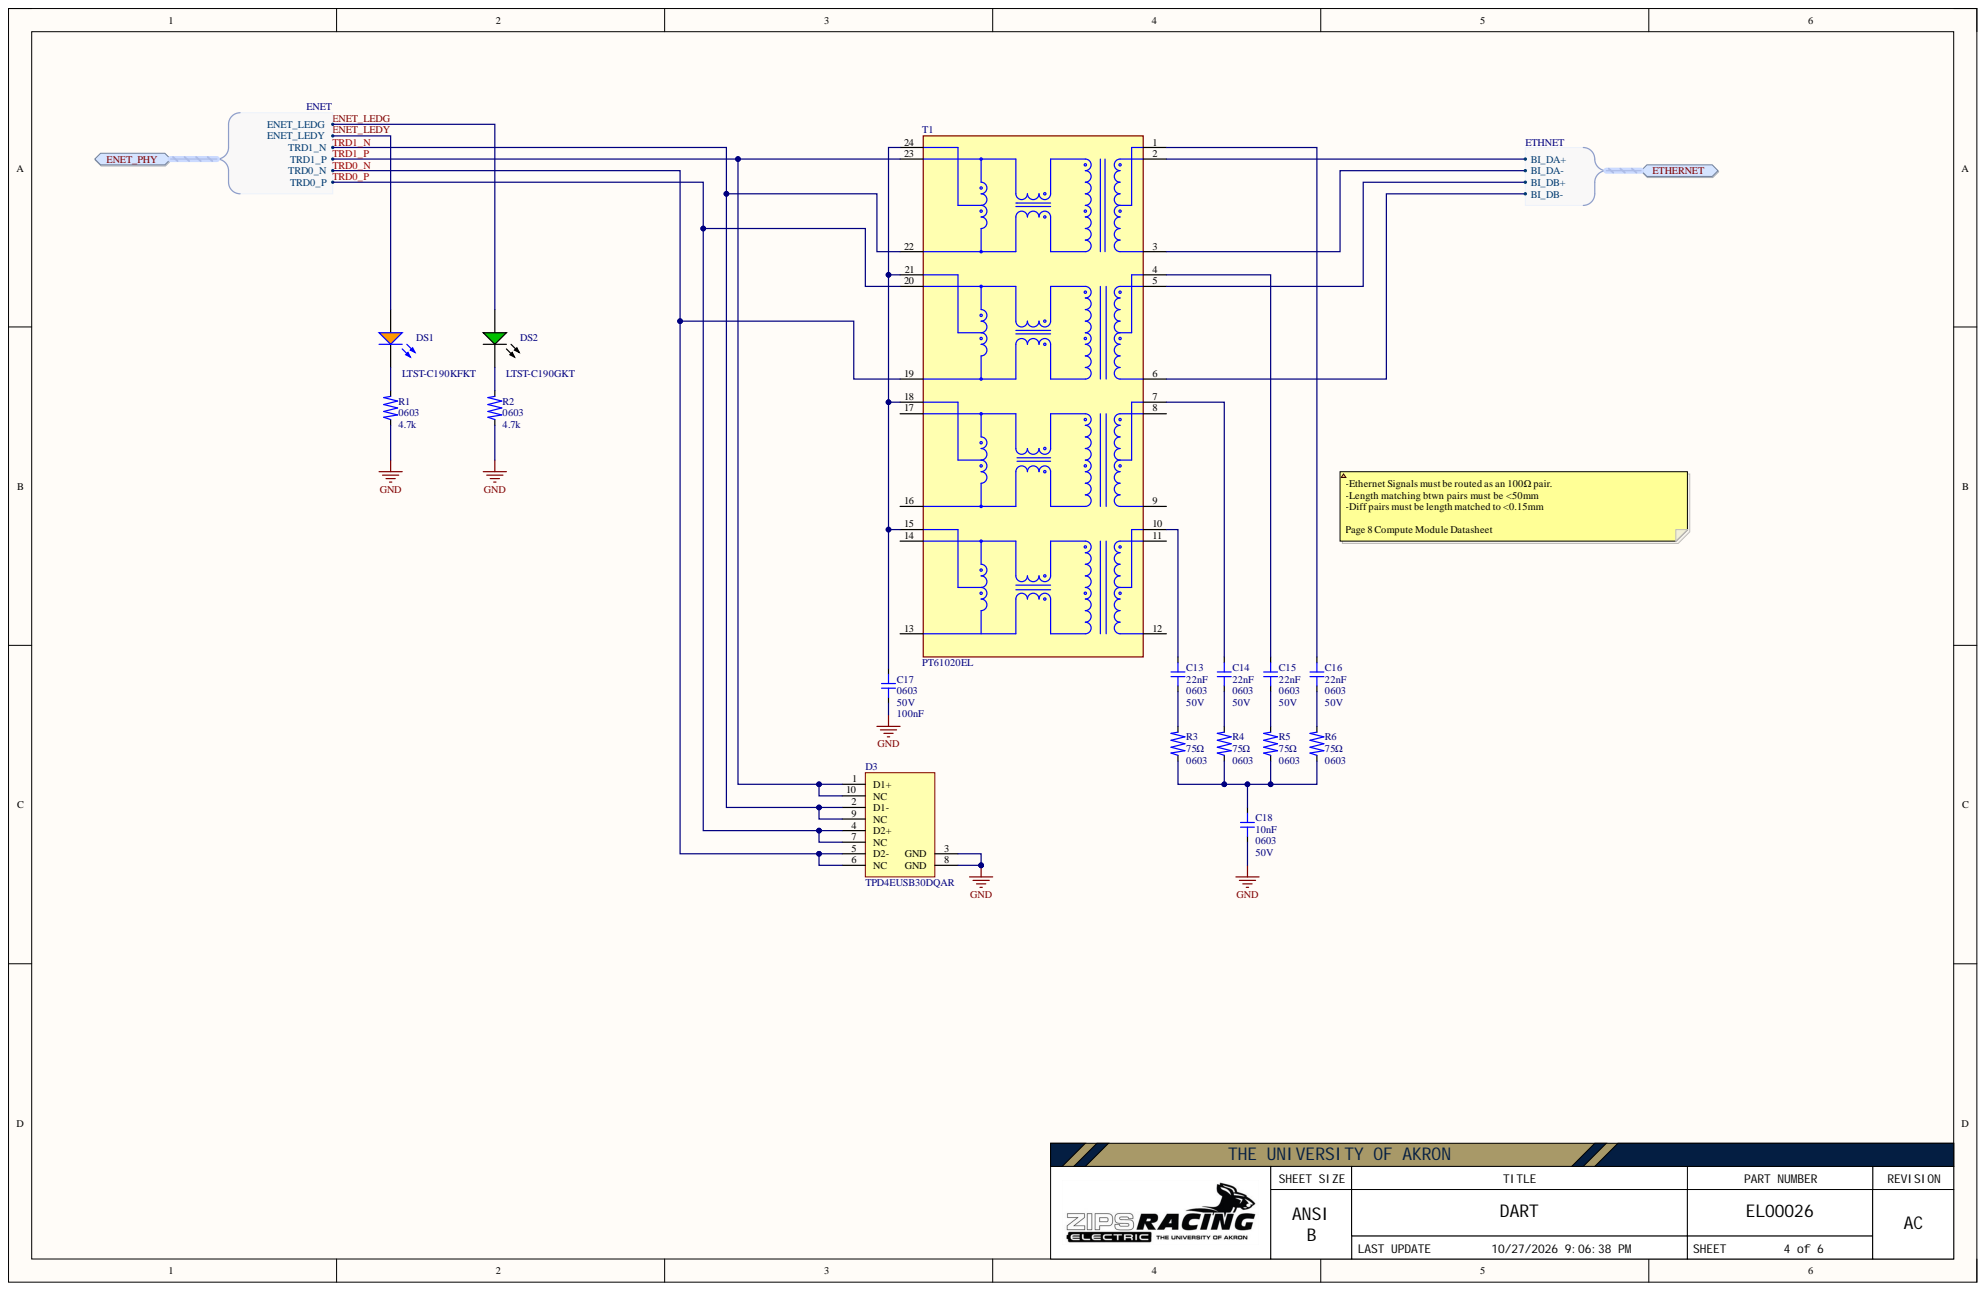
[picture p5: page 5]

TRD0_N | 22
TRD0_P

-Ethernet Signals must be routed as an 100Ω pair.
-Length matching btwn pairs must be <50mm
-Diff pairs must be length matched to <0.15mm

Page 8 Compute Module Datasheet

NC 7
D2- 5

THE UNIVERSITY OF AKRON

SHEET SIZE | TITLE | PART NUMBER | REVISION
ANSI B | DART | EL00026 | AC

LAST UPDATE 10/27/2026 9:06:38 PM | SHEET 4 of 6

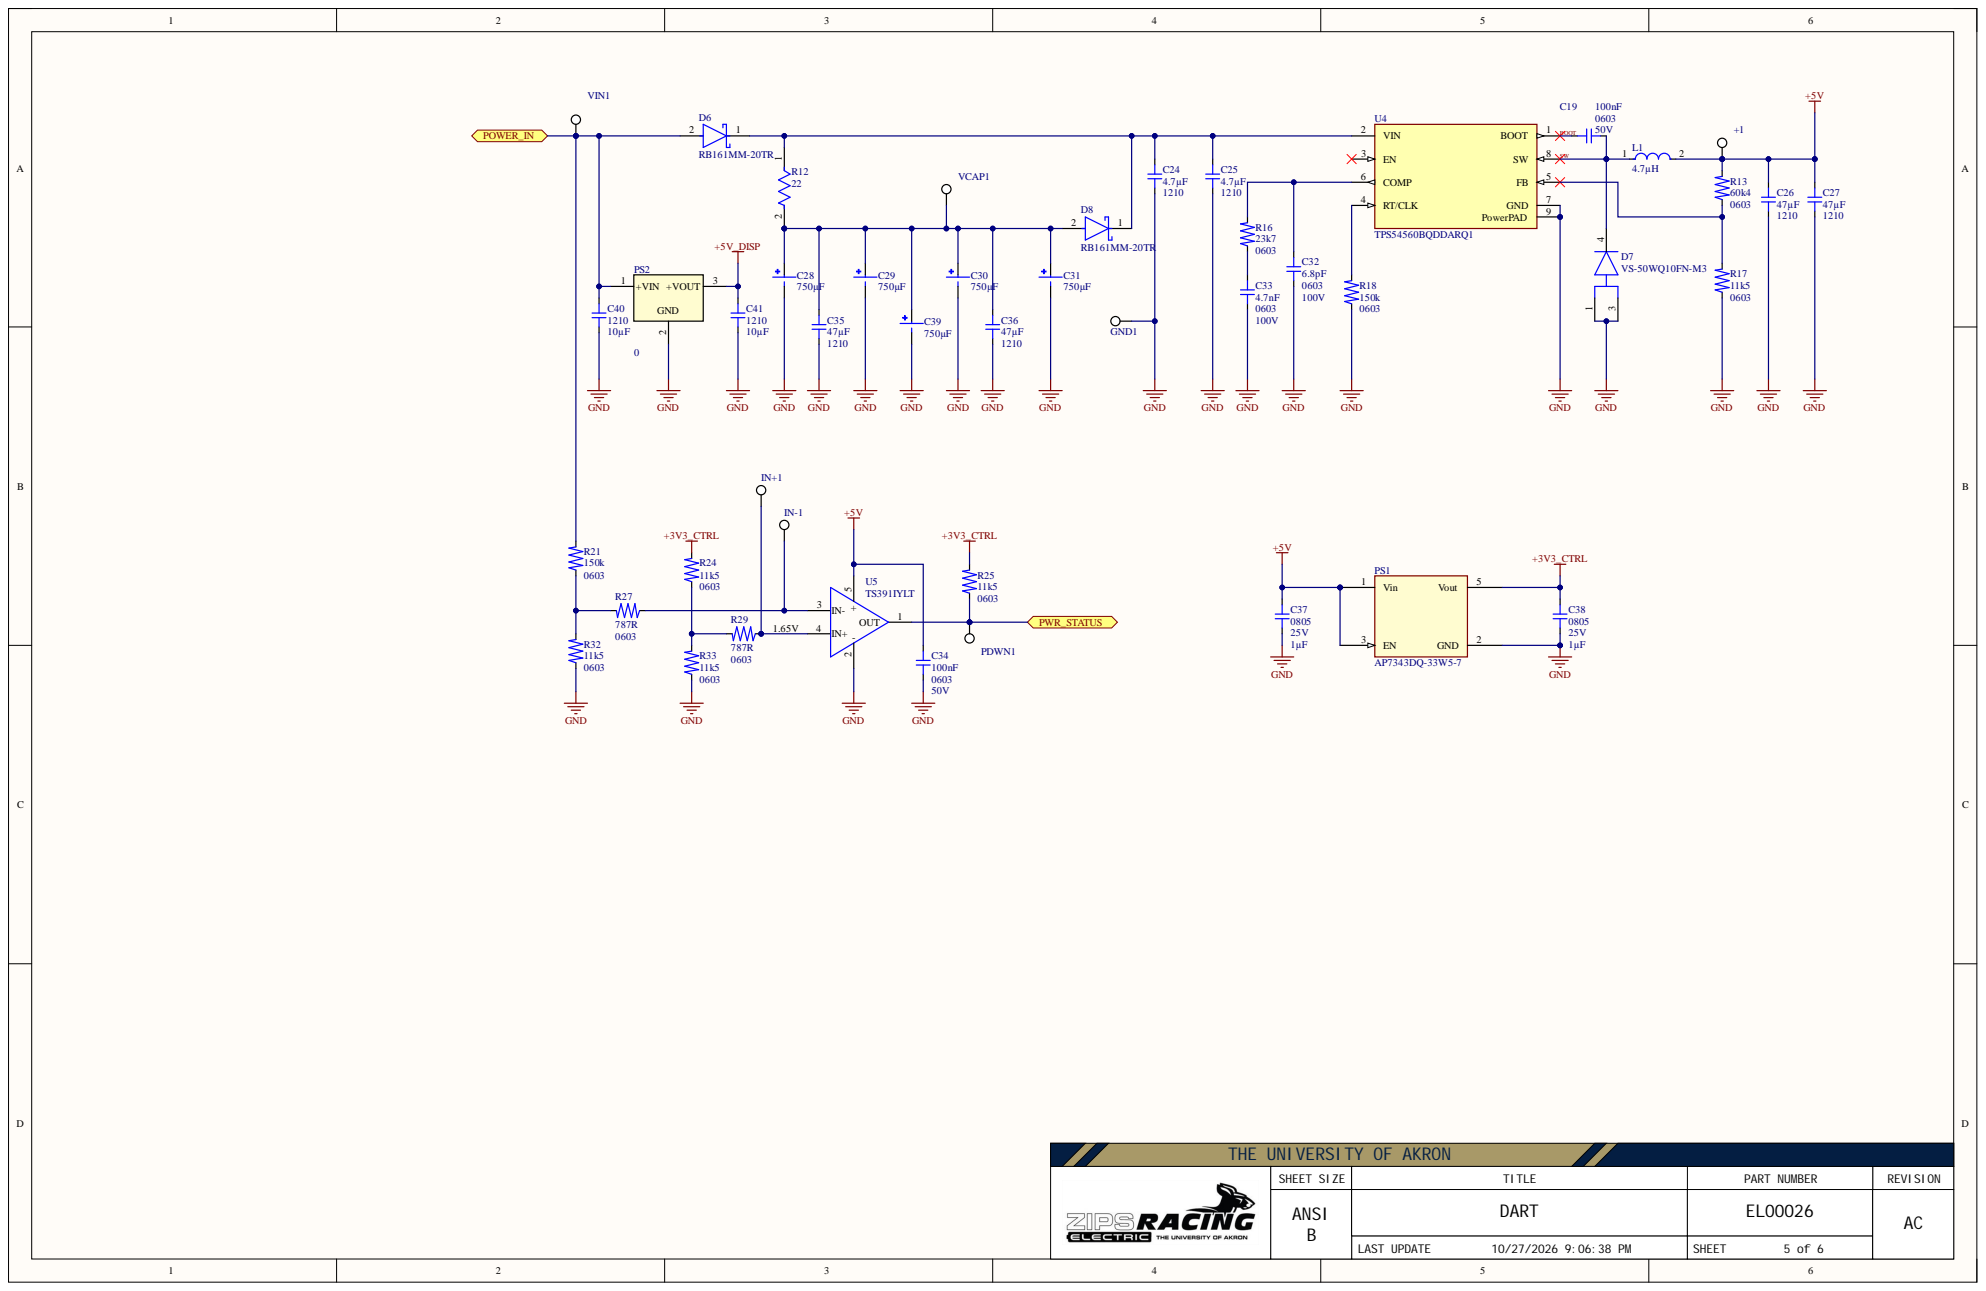
[picture p6: page 6]

THE UNIVERSITY OF AKRON

SHEET SIZE | TITLE | PART NUMBER | REVISION
ANSI B | DART | EL00026 | AC

LAST UPDATE 10/27/2026 9:06:38 PM | SHEET 5 of 6

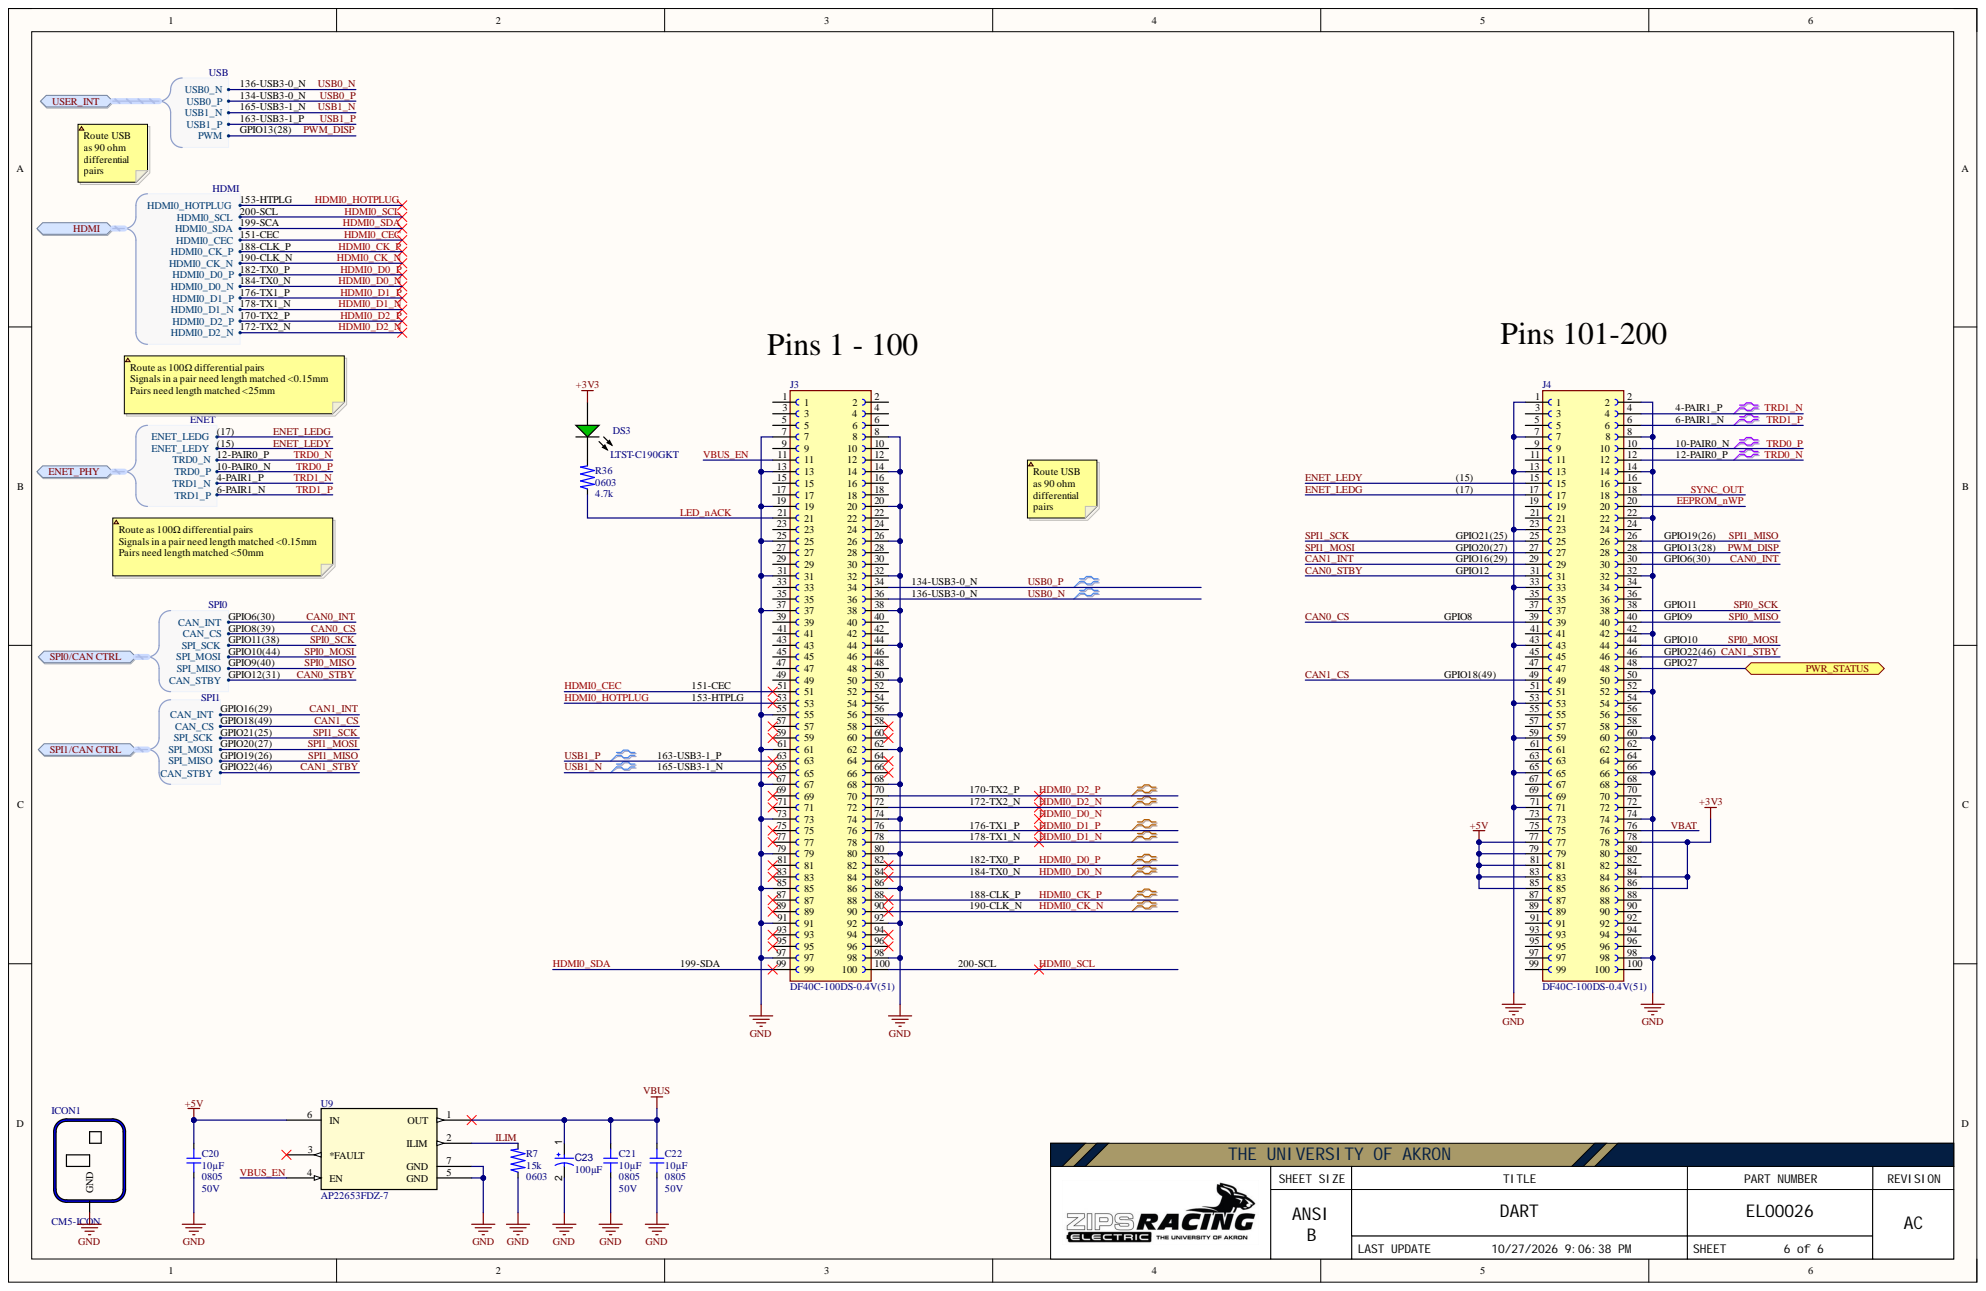
[picture p7: page 7]

Route as 100Ω differential pairs
Signals in a pair need length matched <0.15mm
Pairs need length matched <25mm

Pairs need length matched <50mm

THE UNIVERSITY OF AKRON VBUS_EN

ANSI B | DART | EL00026 | AC

GND

LAST UPDATE 10/27/2026 9:06:38 PM | SHEET 6 of 6
